anumula-sahithi/Quadrature-Down-Converter/README.md

# Quadrature Down Converter (QDC) Project

## Overview
This project aims to develop a Quadrature Down Converter (QDC) for frequency down-conversion applications. The process includes analyzing system requirements, designing the circuit, simulating the design, and implementing a practical QDC. The primary components of the project include a Quadrature Oscillator, Mixer Circuit, and Low Pass Filter.

## Objectives
1. *System Analysis*: Assess the operational requirements for a QDC.
2. *Design*: Create an efficient circuit architecture for the QDC.
3. *Simulation: Virtually test the designed QDC to verify its functionality using *LTSPICE**
4. *Implementation*: Realize the QDC physically and validate its performance.

## Key Features
- *Quadrature Oscillator*: Generates two sinusoidal signals with a 90-degree phase difference.
- *Mixer Circuit*: Multiplies input signals for frequency conversion.
- *Low Pass Filter*: Removes high-frequency components to isolate the desired signal.

## Prerequisites
1. Basic knowledge of circuit design and signal processing.
2. Familiarity with simulation tools (e.g., LTspice, NGSPICE, MATLAB).
3. Access to hardware for physical implementation.

## Project Structure
1. *System Analysis*:
   - Define the target specifications (frequency range, signal quality, etc.).
   - Identify key challenges in QDC design.
2. *Circuit Design*:
   - Develop a schematic of the QDC, including oscillator, mixer, and filter stages.
   - Choose appropriate components and values to meet performance goals.
3. *Simulation*:
   - Simulate the QDC in a virtual environment to test its performance.
   - Analyze simulation results to refine the design.
4. *Implementation*:
   - Build the QDC using real components on a PCB or breadboard.
   - Test the implemented QDC with actual signals and measure its performance.

## Expected Outcomes
1. A fully functional QDC capable of down-converting input frequencies.
2. Documented performance metrics such as conversion gain, linearity, and noise figure.
3. Insights and recommendations for future improvements.

## Challenges and Considerations
- Maintaining phase accuracy in the Quadrature Oscillator.
- Minimizing non-linearities and noise in the Mixer Circuit.
- Achieving the desired cutoff frequency and roll-off characteristics in the Low Pass Filter.
