anumula-sahithi/Quadrature-Down-Converter/Project report.pdf

XXX-X-XXXX-XXXX-X/XX/$XX.00 ©20XX IEEE

# Quadrature Down Converter

KEERTHI SEELA
2023102012
IIIT Hyderabad
keerthi.seela@students.iiit.ac.in

ANUMULA VENKATA SAI SREE SAHITHI 2023112002
IIIT Hyderabad
sahithi.anumula@research.iiit.ac.in

Abstract—The objective of this project is to develop a Quadrature Down Converter (QDC), enabling frequency down-conversion. The project will involve a comprehensive analysis of system requirements, followed by the design, simulation, and practical realization of the QDC. Through systematic examination of operational needs, circuit design, virtual testing, and physical implementation.

Keywords—Quadrature Oscillator, Mixer circuit, low pass filter

I. INTRODUCTION (HEADING 1)
The quadrature down converter converts the high-frequency quadrature signals into low-frequency signals. This conversion is essential for extraction of information from received signals. Internally, a quadrature down converter preserves the in-phase (I) and quadrature-phase (Q) components of the input signal while shifting its frequency. This is typically achieved through a combination of mixing, filtering, and amplification stages integrated into the converter's design.

In this project, we are developing a quadrature down converter by choosing and integrating essential components like mixers, filters, and oscillators. The primary goal is to create a high-performance system that can effectively convert high-frequency signals to low-frequency signals while preserving signal integrity. This involves optimizing each stage of the down converter to achieve efficient frequency conversion.

A QDC has three main components. They are:

1) Qudrature Oscillator:
This oscillator circuit generates two
high-frequency signals characterized by a phase disparity of 90°.
2) Mixer Circuit (or) Switch:
This circuit (which includes
MOSFET as an important component) performs signal mixing by combining two input signals, one sourced externally and the other derived from the oscillator, resulting in the generation of a mixed signal.
3) Low Pass Filter:
This filter selectively attenuates high-frequency signals while allowing low-frequency signals to pass through, based on its defined cut-off frequency.

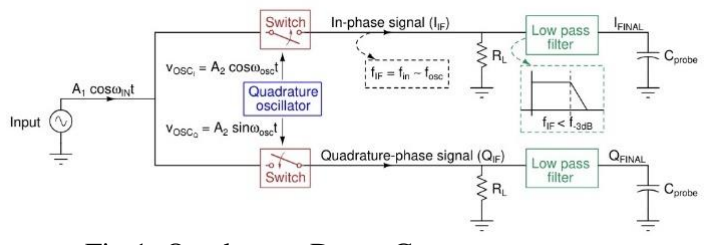
[picture p1: figure]

Fig.1: Quadrature Down Converter

II. CIRCUIT ANALYSIS
The Quadrature Oscillator is given an input of 0V, so the offset DC voltage is taken as input and the op-amp amplifies it to sine wave and cosine waves. Op Amps are used to give a negative feed-back and add a phase of 180 °in each feedback. If a phase difference of 90° is given as feed-back then, the amplitude would continuously rise. To avoid this, we need to make it 180°. In a Quadrature Down-Conversion (QDC) oscillator, the integrator and phase shifter are crucial components that work together to generate quadrature (90-degree phase-shifted) signals. These signals are essential in
various | applications, | including | frequency | synthesis,
modulation, and demodulation

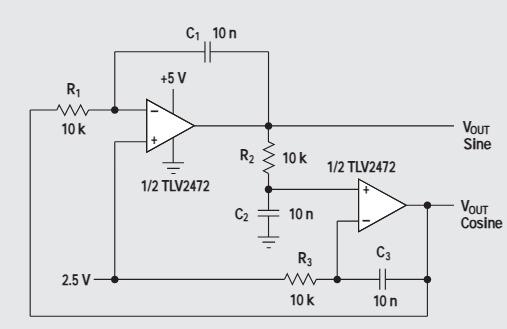
[picture p2: figure]

Fig.2: Quadrature Oscillator

The mixer circuit(switch) contains a MOSFET which
operates | in | Triode | region | and | the | following | is
the working of it.
The working of the circuit is as follows:
- Voltage input from the oscilloscope =
VOSC = A1 sin (2πt - 100k)
- Voltage input from the external source =

VIN = A2 sin (2πt - 99k)
- Biasing Voltage = VBIAS

Vg = VBIAS + VOSC
Vs = VIN
Vb = 0
Now,

VGS = VBIAS + VOSC + VIN
Vbias is approximated to the value of Threshold voltage of MOSFET
∴ | VGS − VTH = VOSC − VIN
∴ if | VOSC − VIN < 0
=⇒ IDS = 0
=⇒ the MOSFET is in Cut-off Region. if
| VOSC − VIN > 0
=⇒ the MOSFET is in Triode region
Note that the MOSFET never goes to saturation, because:

VOUT << VIN << VOSC

VDS − VGS = VOUT − VIN − VBIAS − VOSC + VIN

VDS − VGS = VOUT − VBIAS − VOSC

VDS − VGS < −VBIAS
for a triode to be in saturation,

VDS > VGS − VTH
But, this condition is never satisfied. So, it can be said that MOSFET never enters saturation

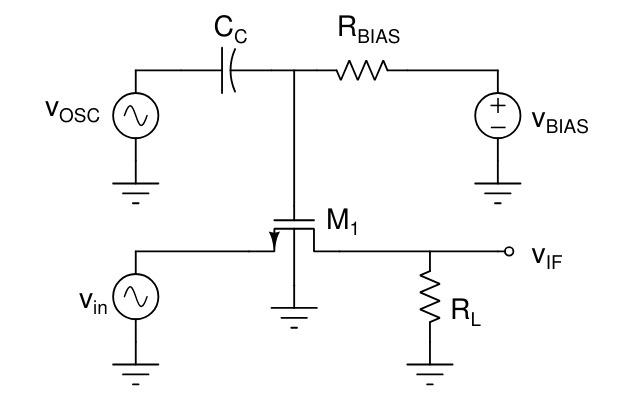
[picture p3: figure]

Fig.3: Mixer
A low-pass filter is designed to reduce or suppress high-frequency signals while allowing low-frequency signals to pass through with minimal alteration. The cutoff frequency marks the point where the filter begins attenuating higher frequencies. The roll-off characteristic indicates how rapidly the filter's attenuation increases beyond this cutoff frequency Fc =1/2πRC

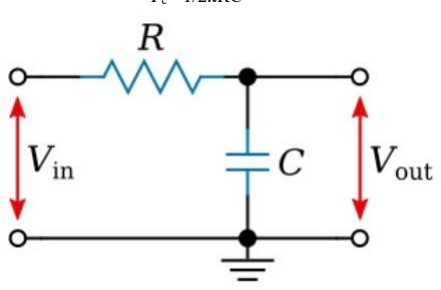
[picture p4: figure]

Fig.4: Low pass filter

III. QUADRATURE OSCILLATOR DESIGN

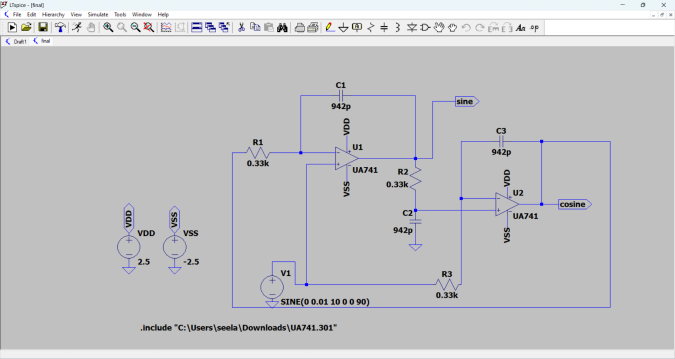
[picture p5: figure]

Fig.5: LTSPICE of Quadrature Oscillator

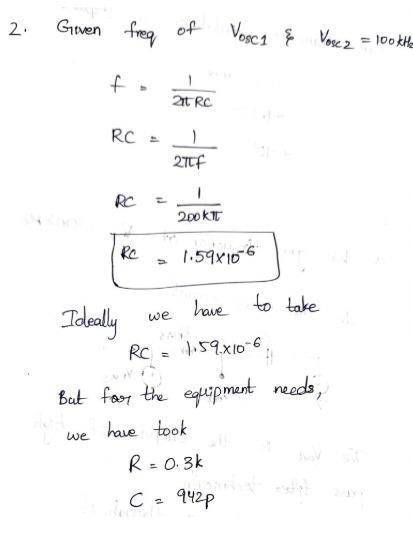
[picture p6: figure]

Fig.6: Calculations of R and C

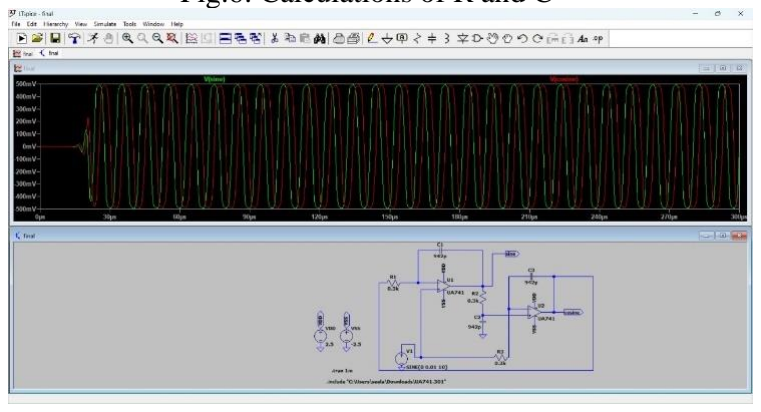
[picture p7: figure]

Fig.7: VOSCI and VOSCQ Transient Plots

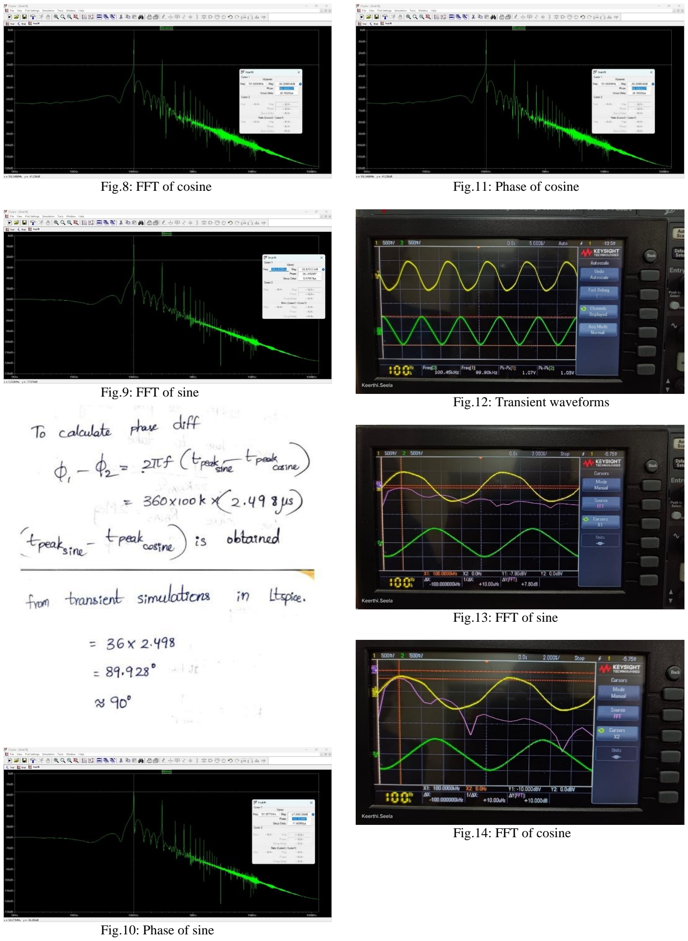
[picture p8: page 3]

Fig.8: FFT of cosine

Fig.9: FFT of sine

Fig.10: Phase of sine

Fig.11: Phase of cosine

Fig.12: Transient waveforms

Fig.13: FFT of sine

Fig.14: FFT of cosine

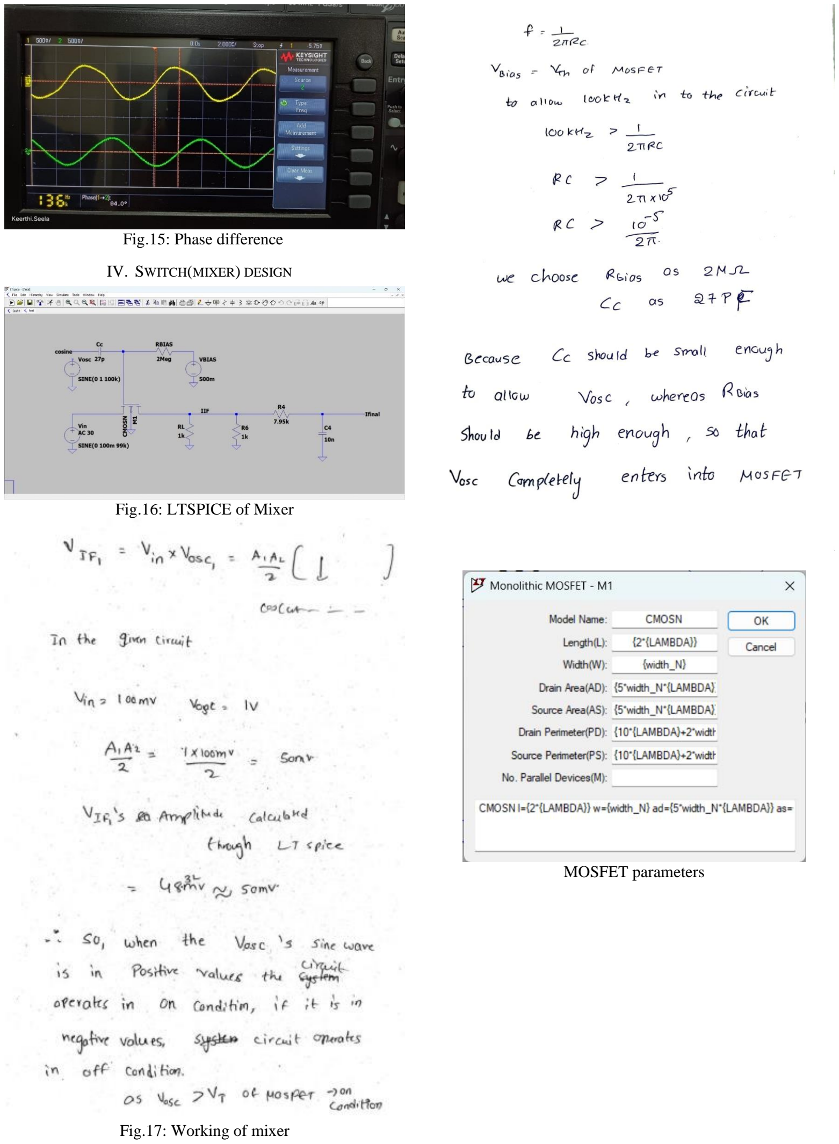
[picture p9: page 4]

Fig.15: Phase difference

IV. SWITCH(MIXER) DESIGN

Fig.16: LTSPICE of Mixer

Fig.17: Working of mixer

MOSFET parameters

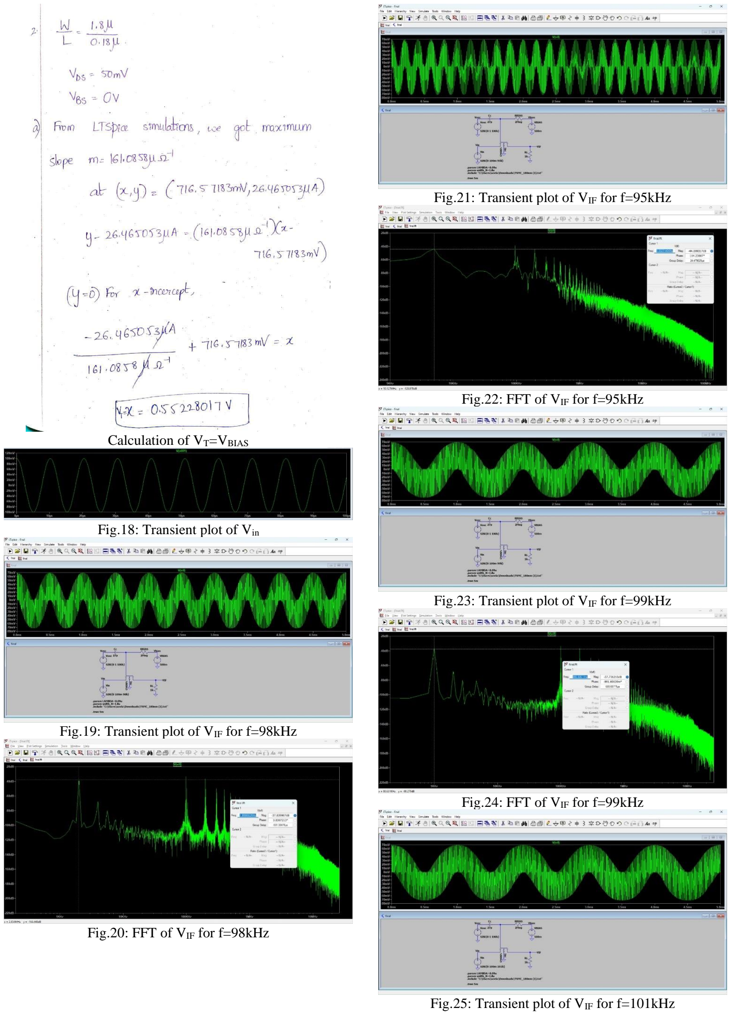
[picture p10: page 5]

Calculation of VT=VBIAS

Fig.18: Transient plot of Vin

Fig.19: Transient plot of VIF for f=98kHz

Fig.20: FFT of VIF for f=98kHz

Fig.21: Transient plot of VIF for f=95kHz

Fig.22: FFT of VIF for f=95kHz

Fig.23: Transient plot of VIF for f=99kHz

Fig.24: FFT of VIF for f=99kHz

Fig.25: Transient plot of VIF for f=101kHz

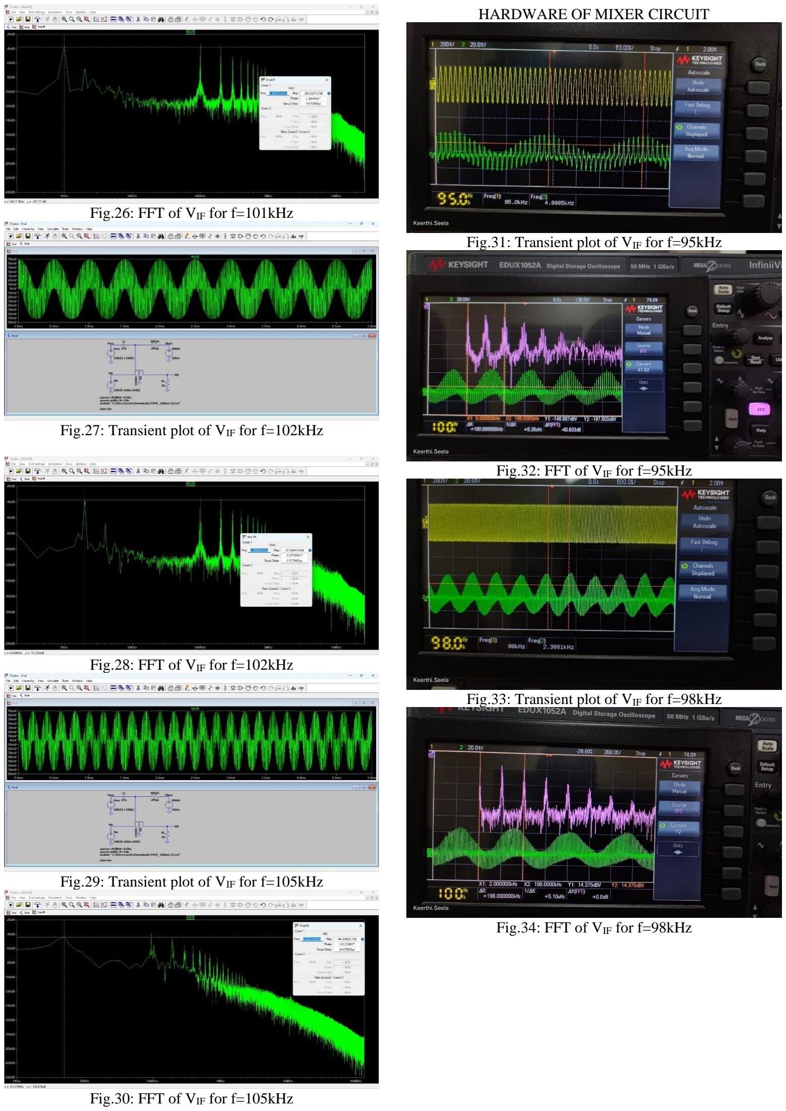
[picture p11: page 6]

Fig.26: FFT of VIF for f=101kHz

Fig.27: Transient plot of VIF for f=102kHz

Fig.28: FFT of VIF for f=102kHz

Fig.29: Transient plot of VIF for f=105kHz

Fig.30: FFT of VIF for f=105kHz

HARDWARE OF MIXER CIRCUIT

Fig.31: Transient plot of VIF for f=95kHz

Fig.32: FFT of VIF for f=95kHz

Fig.33: Transient plot of VIF for f=98kHz

Fig.34: FFT of VIF for f=98kHz

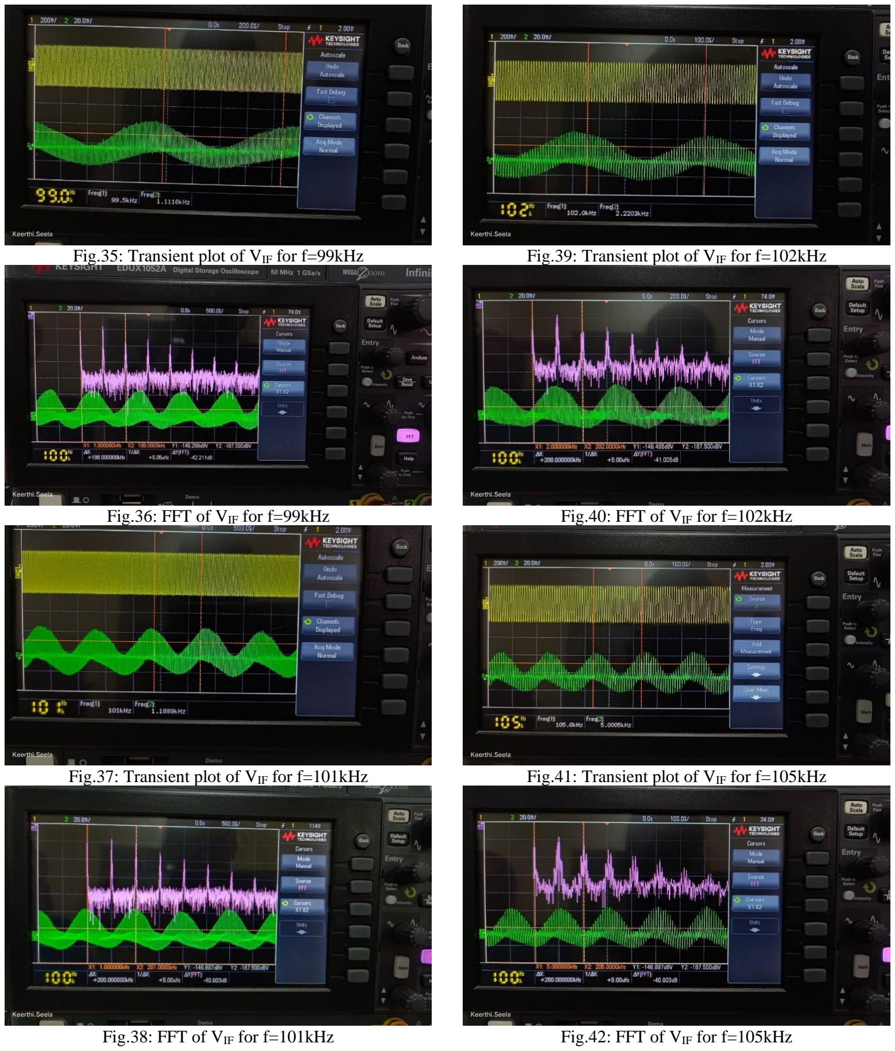
[picture p12: page 7]

Fig.35: Transient plot of VIF for f=99kHz

Fig.36: FFT of VIF for f=99kHz

Fig.37: Transient plot of VIF for f=101kHz

Fig.38: FFT of VIF for f=101kHz

Fig.39: Transient plot of VIF for f=102kHz

Fig.40: FFT of VIF for f=102kHz

Fig.41: Transient plot of VIF for f=105kHz

Fig.42: FFT of VIF for f=105kHz

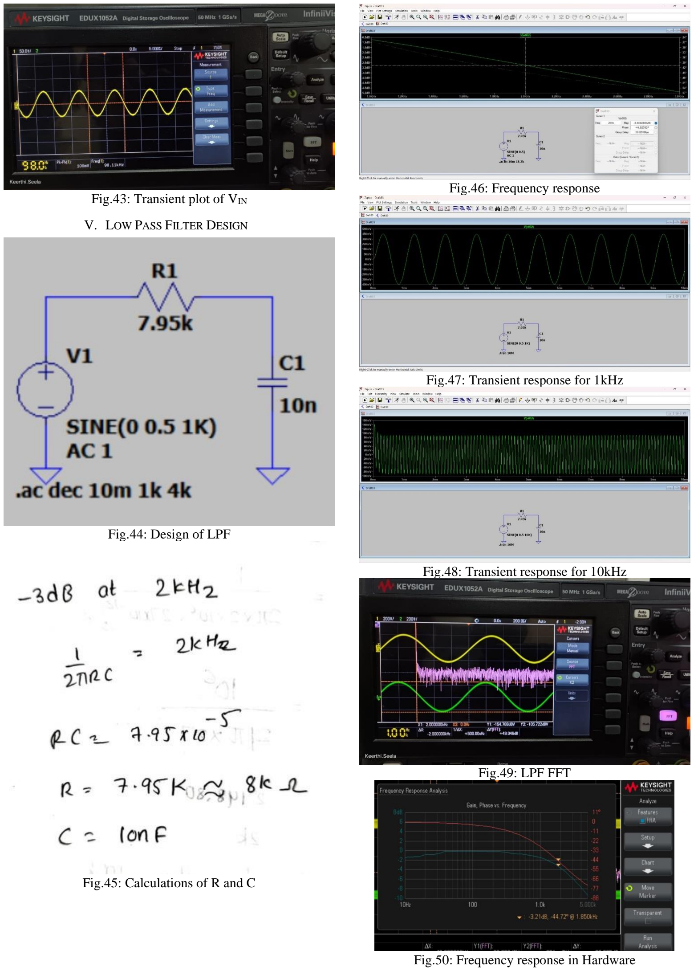
[picture p13: page 8]

Fig.43: Transient plot of VIN

V. LOW PASS FILTER DESIGN

Fig.44: Design of LPF

Fig.45: Calculations of R and C

Fig.46: Frequency response

Fig.47: Transient response for 1kHz

Fig.48: Transient response for 10kHz

Fig.49: LPF FFT

Fig.50: Frequency response in Hardware

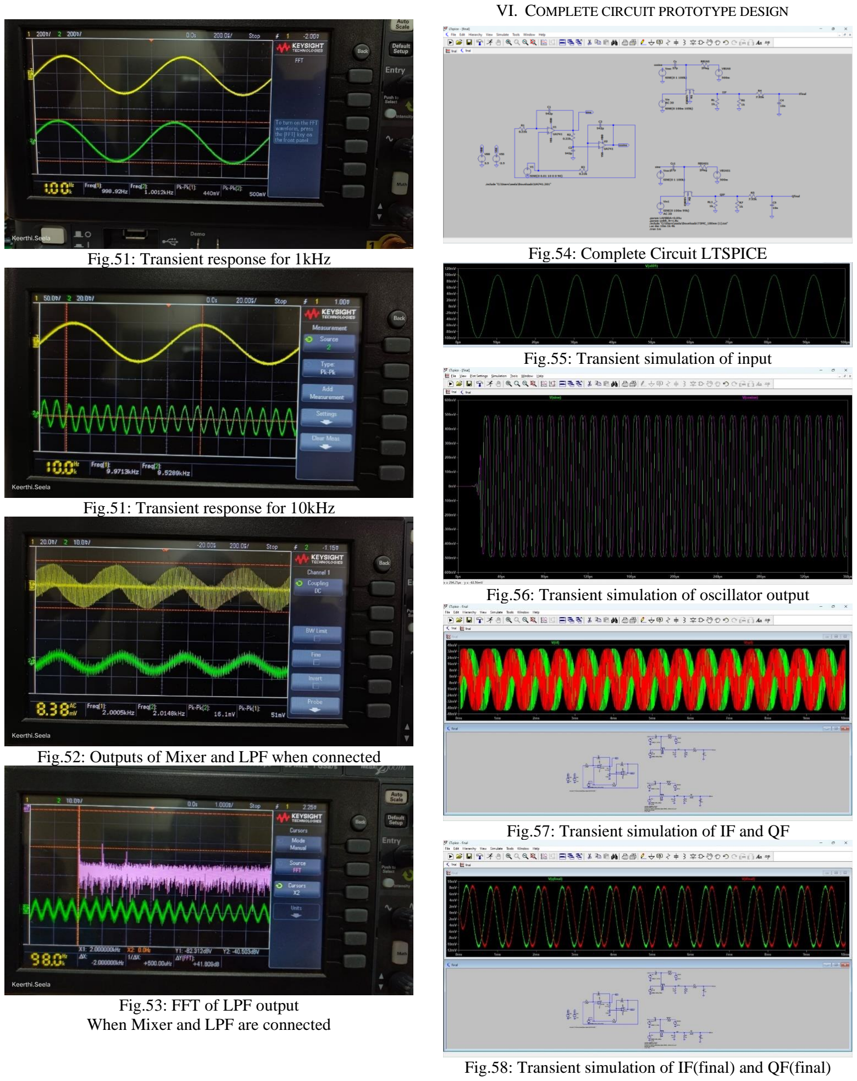
[picture p14: page 9]

Fig.51: Transient response for 1kHz

Fig.51: Transient response for 10kHz

Fig.52: Outputs of Mixer and LPF when connected

Fig.53: FFT of LPF output
When Mixer and LPF are connected

VI. COMPLETE CIRCUIT PROTOTYPE DESIGN

Fig.54: Complete Circuit LTSPICE

Fig.55: Transient simulation of input

Fig.56: Transient simulation of oscillator output

Fig.57: Transient simulation of IF and QF

Fig.58: Transient simulation of IF(final) and QF(final)

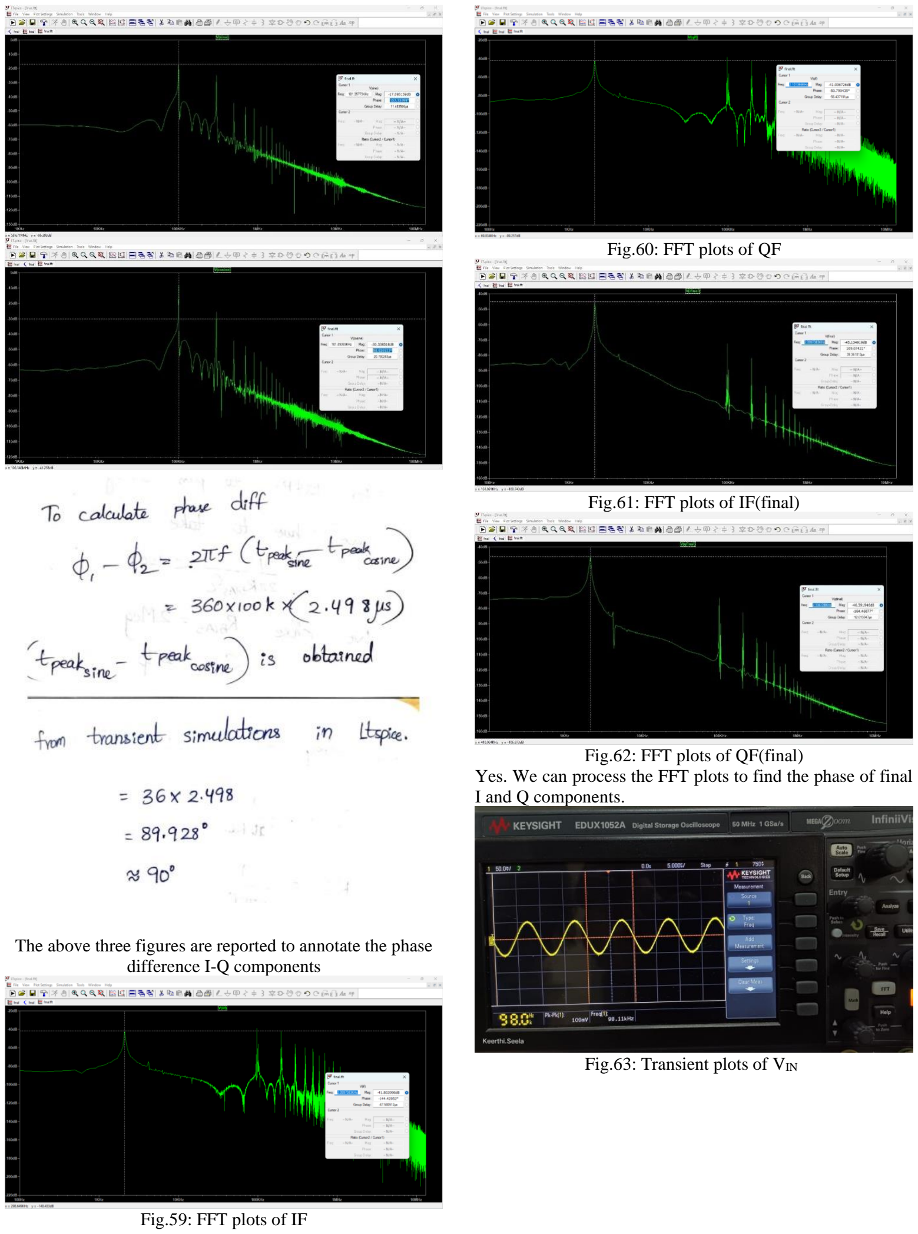
[picture p15: page 10]

The above three figures are reported to annotate the phase difference I-Q components

Fig.59: FFT plots of IF

Fig.60: FFT plots of QF

Fig.61: FFT plots of IF(final)

Fig.62: FFT plots of QF(final) Yes. We can process the FFT plots to find the phase of final I and Q components.

Fig.63: Transient plots of VIN

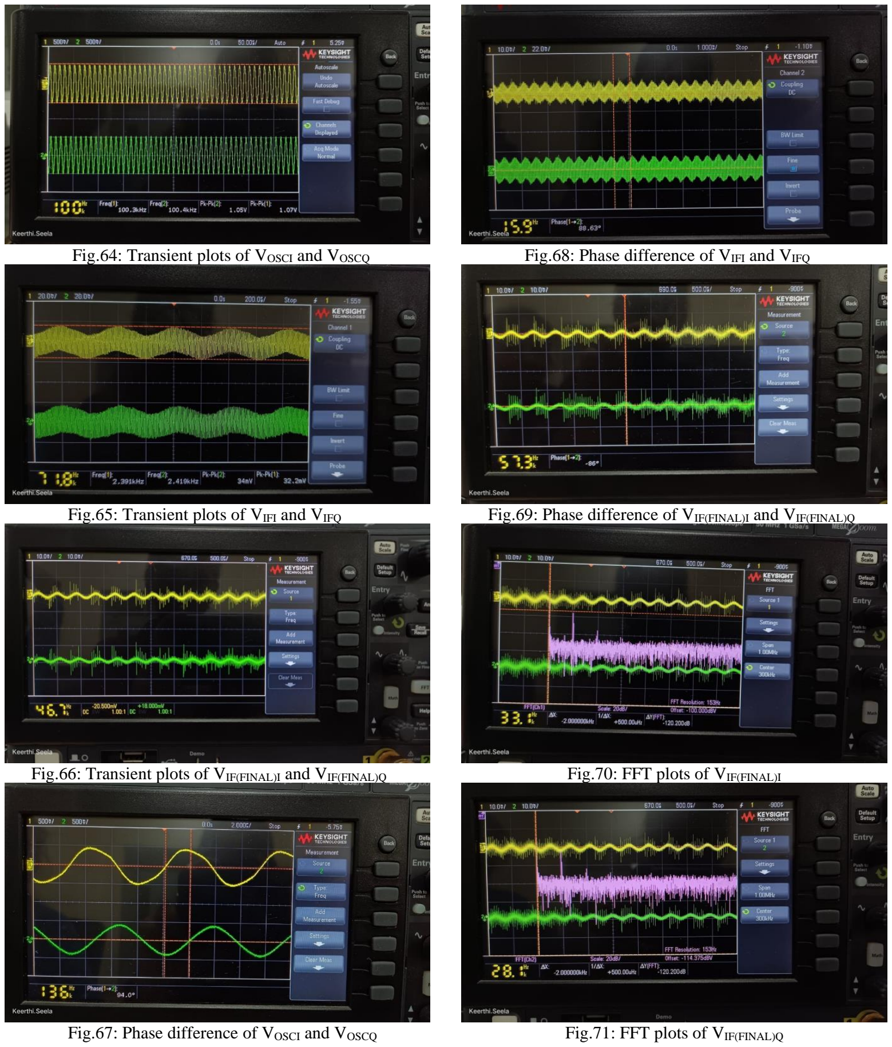
[picture p16: page 11]

Fig.64: Transient plots of VOSCI and VOSCQ

Fig.65: Transient plots of VIFI and VIFQ

Fig.66: Transient plots of VIF(FINAL)I and VIF(FINAL)Q

Fig.67: Phase difference of VOSCI and VOSCQ

Fig.68: Phase difference of VIFI and VIFQ

Fig.69: Phase difference of VIF(FINAL)I and VIF(FINAL)Q

Fig.70: FFT plots of VIF(FINAL)I

Fig.71: FFT plots of VIF(FINAL)Q

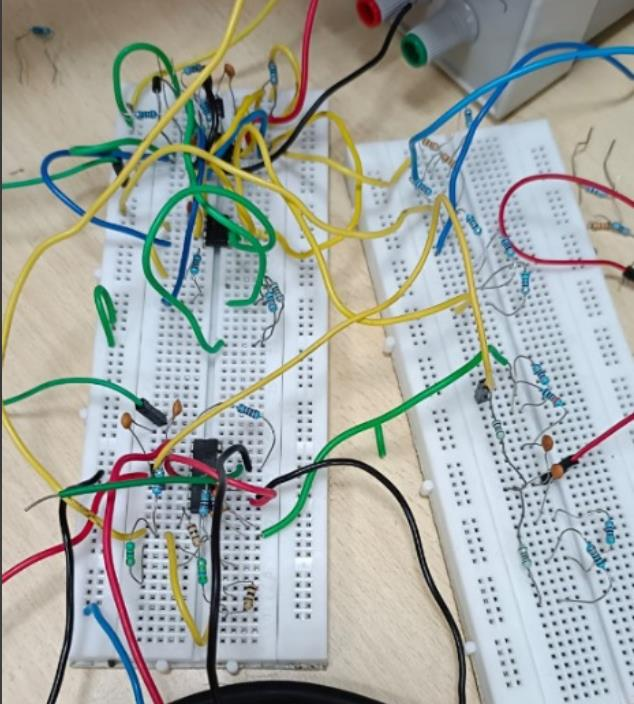
[picture p17: figure]

Fig.72: Circuit Overview
Parameters | Simulated | Measured
Oscillator Frequency (I-phase) | 100kHz | 100.3kHz
Oscillator Frequency (Q-phase) | 100.18kHz | 100.4kHz
Oscillator Amplitude (I-phase) | 1V | 1.05V
Oscillator Amplitude (Q-phase) | 1V | 1.07V
Input frequency | 98kHz | 98kHz
Supply – VDD | 2.5V | 6.72V
Supply - VSS | -2.5V | -6.72V
VBIAS | 0.5V | 1.76V
CC | 27pF | 5pF
R – LPF | 7.9kΩ | 8kΩ
C – LPF | 10nF | 10nF

VII. CONTRIBUTIONS
Keerthi Seela
- Simulations in LTSPICE
- Oscillator
- Report
Anumula Venkata Sai Sree Sahithi
- Mixer Circuit
- LPF
- Report and PPT
