anumula-sahithi/Quadrature-Down-Converter/final.asc

C1: cap; 942p
C2: cap; 942p
C3: cap; 942p
C4: cap; 10n
C5: cap; 10n
Cc1: cap; 27p
Cc: cap; 27p
M1: nmos4; CMOSN; l={2*LAMBDA} w={width_N} ad={5*width_N*LAMBDA} as={5*width_N*LAMBDA} pd={10*LAMBDA+2*width_N} ps={10*LAMBDA+2*width_N}
M2: nmos4; CMOSN; l={2*LAMBDA} w={width_N} ad={5*width_N*LAMBDA} as={5*width_N*LAMBDA} pd={10*LAMBDA+2*width_N} ps={10*LAMBDA+2*width_N}
R1: res; 0.33k
R2: res; 0.33k
R3: res; 0.33k
R4: res; 7.95k
R5: res; 7.95k
R6: res; 1k
R7: res; 1k
RBIAS1: res; 2Meg
RBIAS: res; 2Meg
RL1: res; 1k
RL: res; 1k
U1: opamp2; UA741
U2: opamp2; UA741
V1: voltage; SINE(0 0.01 10 0 0 90)
VBIAS1: voltage; 500m
VBIAS: voltage; 500m
VDD: voltage; 2.5
Vin1: voltage; SINE(0 100m 97.5k); AC 30
Vin: voltage; SINE(0 100m 97.5k); AC 30
Vosc1: voltage; SINE(0 1 100k)
Vosc: voltage; SINE(0 1 100k)
VSS: voltage; -2.5
Named nets: 0, VSS, VDD, sine, cosine, IIF, QIF, Qfinal, Ifinal
.include "C:\\Users\\seela\\Downloads\\UA741.301"
.include "C:\\Users\\seela\\Downloads\\TSMC_180nm (1).txt"
.param LAMBDA=0.09u
.param width_N=1.8u
;.ac dec 10m 1k 4k
.tran 10m
